entropia/Teebeutel-Hardware/README.md

# Teebeutel

An (experimental) ESP32-dev-board in the shape of the Entropia logo.

Head over to the [wiki](https://gitlab.jadyn.dev/jadyn/Teebeutel/-/wikis/home) for more information.

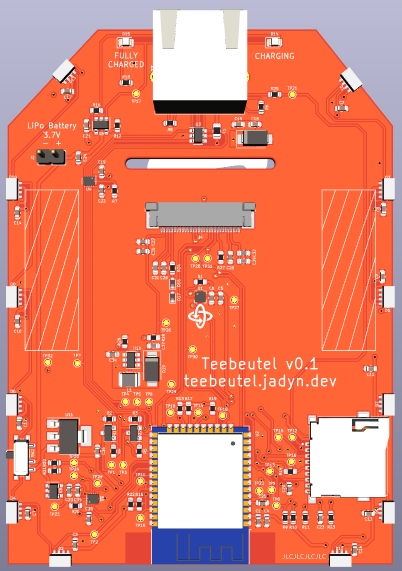
[picture p1: DOCS/3D-Front.png]
3D Render of the front

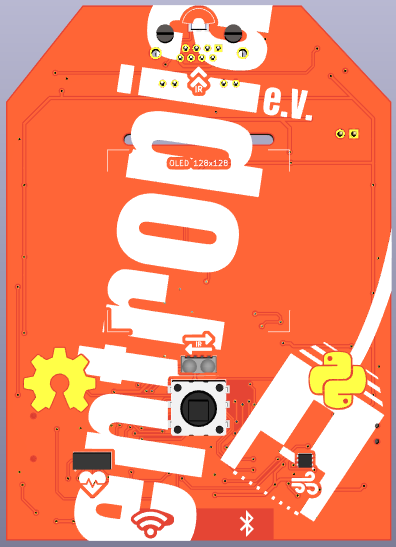
[picture p2: DOCS/3D-Back.png]
3D Render of the back
