entropia/Teebeutel-Hardware/docs/modules/sensor/nav.adoc

* Sensors
** xref:spo2.adoc[]
** xref:gas.adoc[]
** xref:hall-sensor.adoc[]
** xref:touch.adoc[]
** xref:d-pad.adoc[]
