entropia/Teebeutel-Hardware/docs/modules/pcb/nav.adoc

* PCB
** xref:bom.adoc[BOM]
** xref:testpads.adoc[Testpads]
