entropia/Teebeutel-Hardware/graphics/fairydust.png

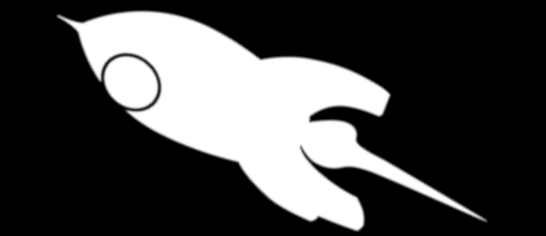
graphics/fairydust.png
