entropia/Teebeutel-Hardware/graphics/name_tag.png

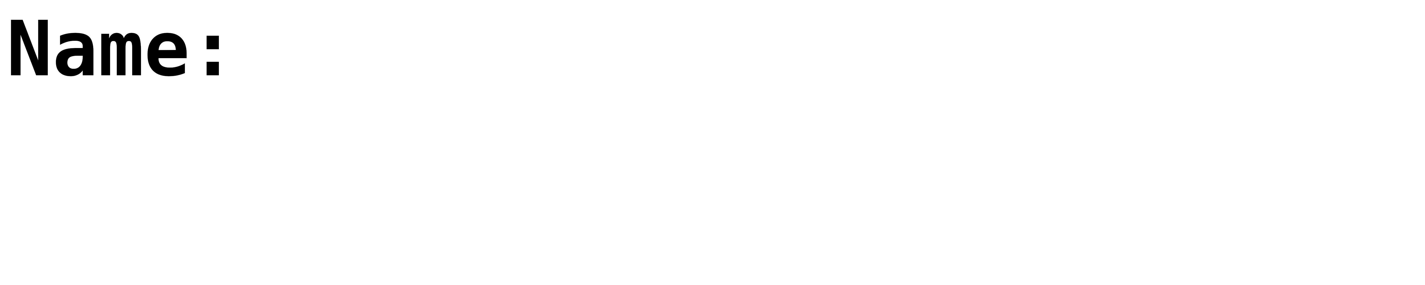
graphics/name_tag.png
