entropia/Teebeutel-Hardware/graphics/teebeutel.png

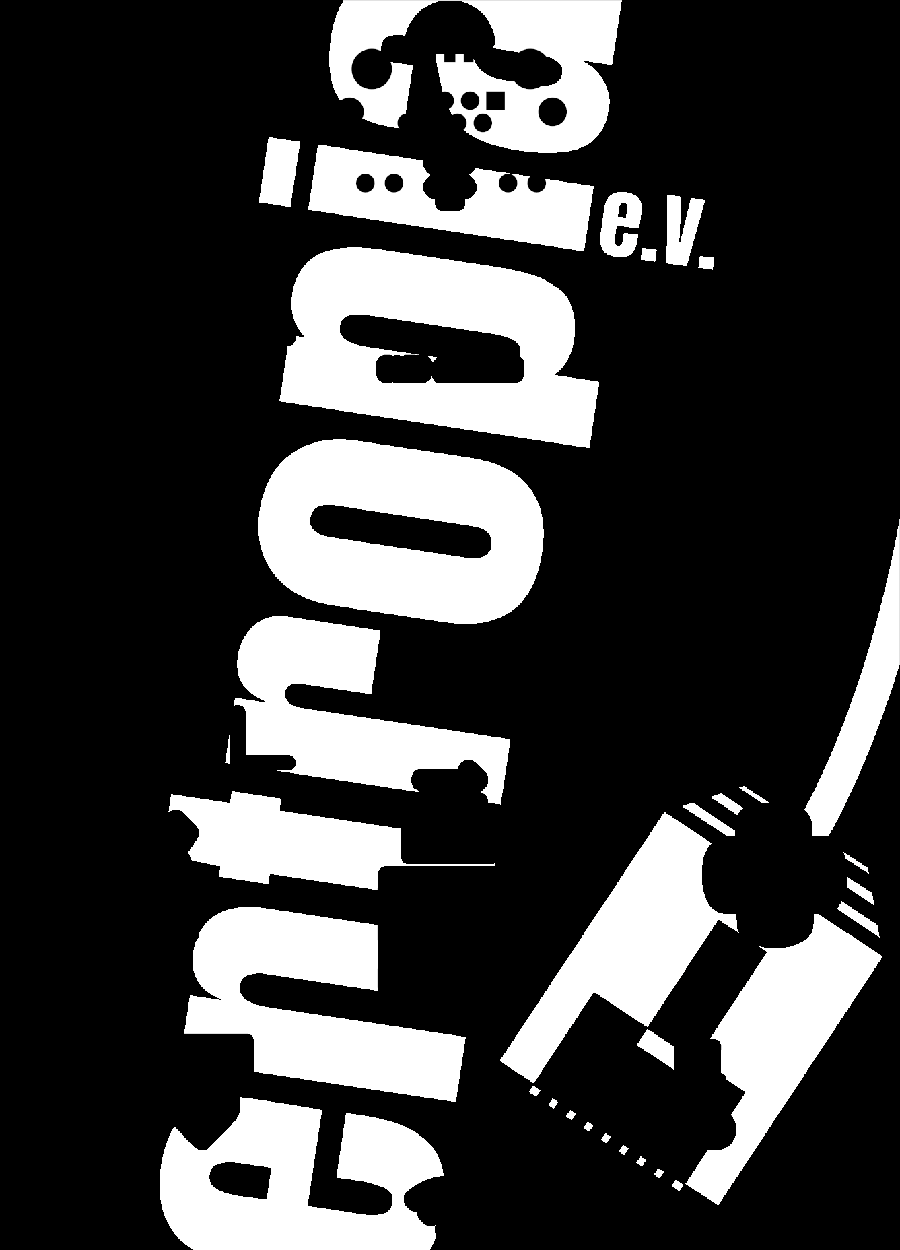
graphics/teebeutel.png
