entropia/Teebeutel-Hardware/docs/modules/pcb/attachments/testpads.csv

Reference | Description
TP1 | ESP32 EN
TP2 | ESP32 IO0
TP3 | DTR 3.3V
TP4 | RTS 3.3V
TP5 | OLED MOSI
TP6 | OLED SCK
TP7 | OLED CS
TP8 | OLED DC
TP9 | OLED RESET
TP10 | OLED VPP (13V)
TP11 | SD-Card SCK
TP12 | SD-Card CS
TP13 | SD-Card MOSI
TP14 | SD-Card MISO
TP15 | I²C SDA 1.8V
TP16 | I²C SCL 1.8V
TP17 | EXP-INT
TP18 | EXP-~RST
TP19 | IR-RX
TP20 | IR-TX
TP21 | WS2821
TP22 | VIBRATION
TP23 | Charging status
TP24 | ADC Battery (1/4 Battery voltage)
TP25 | V +3.3V
TP26 | V +1.8V
