entropia/Teebeutel-Hardware/docs/modules/pcb/pages/testpads.adoc

= Teebeutel Testpads

IMPORTANT: Please make sure that you are viewing the correct version!

== Testpads {page-component-version}

[%header,format=csv]
|===
include::../attachments/testpads.csv[]
|===
