entropia/Teebeutel-Hardware/(threads)

Thread 2 (2021-12-23):

The 3.3v Voltage-Regulator requires 4.7V to work

jadyndev, 2021-12-23:
This IC need 4.7V to work properly. We only have 3.7V when the battery is fully charged!

jadyndev, 2021-12-28:
The voltage regulator was replaced with one that can handle Vout = Vin (TLV62568)

Closed 2021-12-28.

Thread 3 (2021-12-25):

UART lables are swapped

jadyndev, 2021-12-25:
The UART RxD and TxD labels are swapped.

TODO:

- [x] Switch labels without changing the pin assignments on the plug.
- [x] Figure out if the ESP boots with RTS and DTR floating

jadyndev, 2021-12-28:
Booting should work, as the strapping pins are internally pulled up. Not tested tho.

Labels have been swapped and the status LEDs should work as well now

Closed 2021-12-28.

Thread 4 (2022-01-02):

Replace I2C level shifter

Jana-Marie, 2022-01-02:
TXB0104RUT is not suited for I2C, replace with mosfet based level shifter.

Jana-Marie, 2022-01-04:
Fixed with 71fb0764d747d6fe92a1aca003bab7134bcb2dd3

Closed 2022-01-04.

Thread 5 (2022-01-02):

Fix PPSI262 pinout issues

Jana-Marie, 2022-01-02:
- [ ] move SCL from CLK pin 7 to SCL pin 10
- [ ] add 510kOhm pull-down to CLK pin 7
- [ ] figure out what RESETZ needs

Jana-Marie, 2022-01-02:
It might be worth investigating if 620kOhm, already on BOM, works as well.

Jana-Marie, 2022-01-04:
Fixed with 71fb0764d747d6fe92a1aca003bab7134bcb2dd3

Investigating 620kOhm is still to-do

Closed 2022-01-04.

Thread 7 (2022-01-02):

Add polygon cutouts to fine-pitched footprints

Jana-Marie, 2022-01-02:
This should improve the soldering process

Jana-Marie, 2022-01-04:
Fixed with 722751b5af8dbf80599c69b61c2438f96eb9160d

Closed 2022-01-04.

Thread 8 (2022-01-02):

Reduce I2C pullup value?

Jana-Marie, 2022-01-02:
10kOhm is quite alot, it may cause some issues with rise times. It should rather be 3.3kOhm or 5.1KOhm, all 10kOhm can probably changed to 5.1kOhm to keep the BOM count low.

Jana-Marie, 2022-01-04:
fixed with 71fb0764d747d6fe92a1aca003bab7134bcb2dd3

Closed 2022-01-04.

Thread 13 (2022-01-20):

Replace S8050 (Q1, Q2) with AO3400

Jana-Marie, 2022-01-20:
This will reduce BOM count by another entry, this should work, lets test it.

jadyndev, 2022-02-13:
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
Just like this?

Jana-Marie, 2022-02-14:
Yes, but please test it first, not sure how stable it is.
