entropia/Teebeutel-Hardware/Teebeutel.kicad_pcb

## KiCad design Teebeutel.kicad_pcb (2022-03-07)

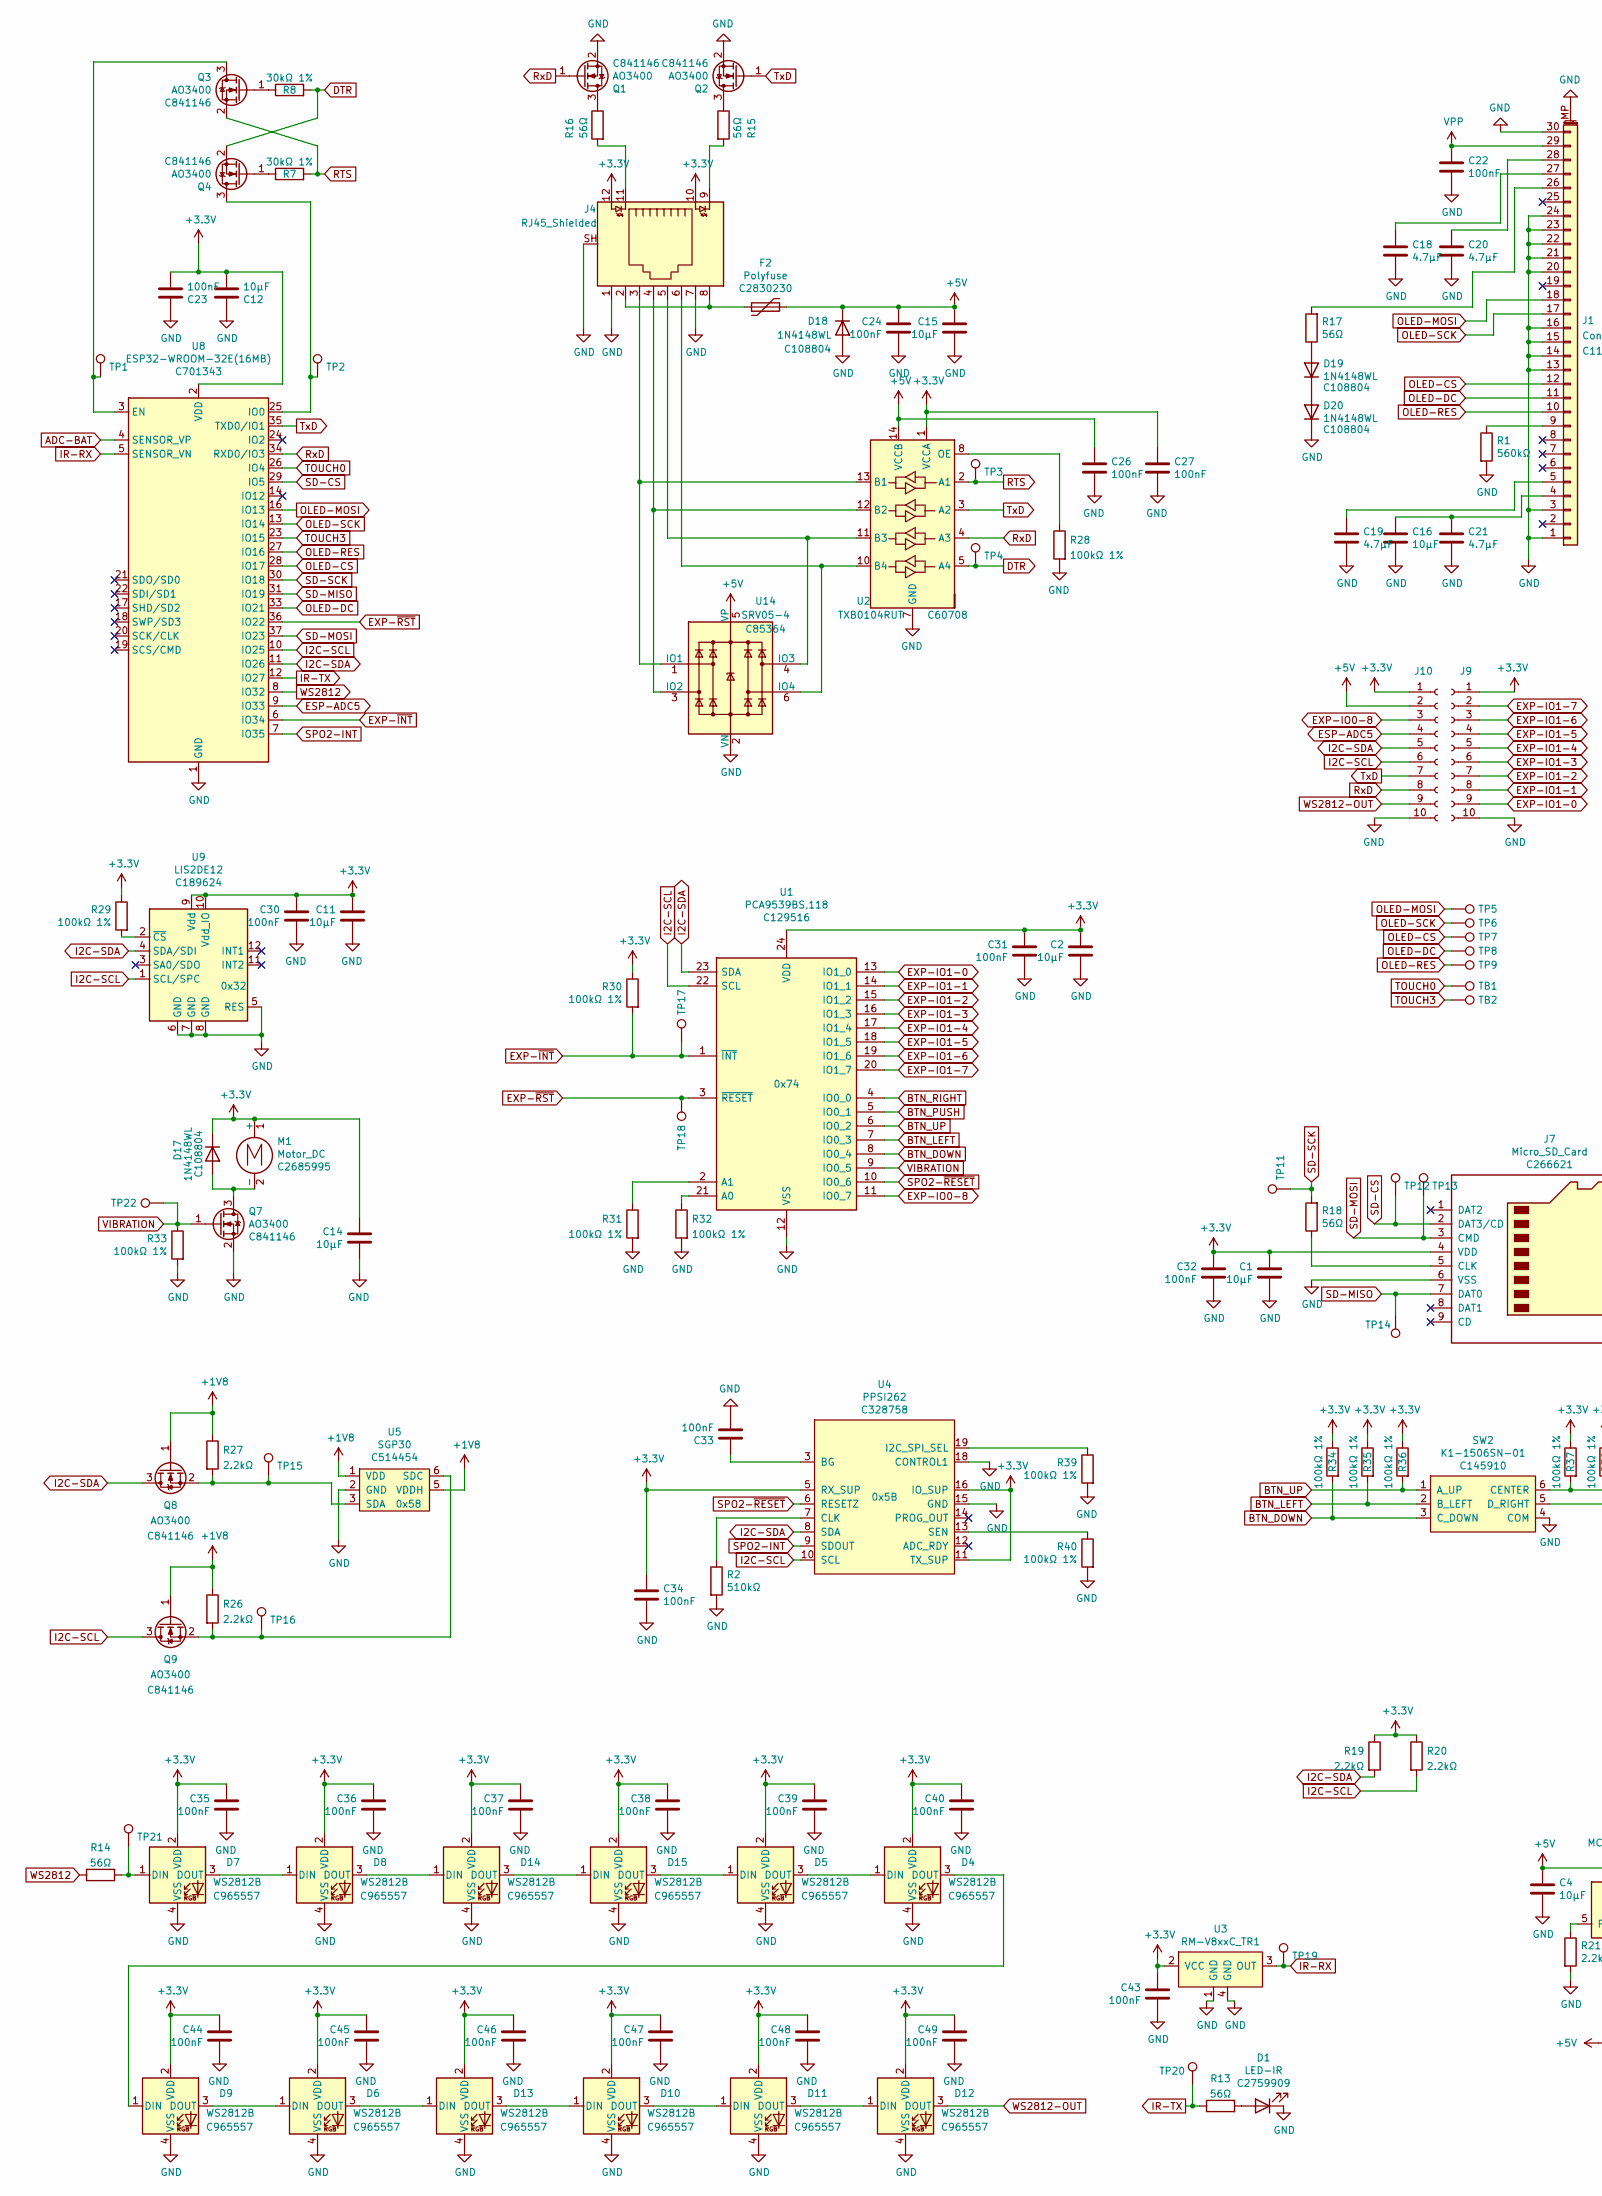
[picture p6: schematic Teebeutel.kicad_sch, part in row 1, column 1]

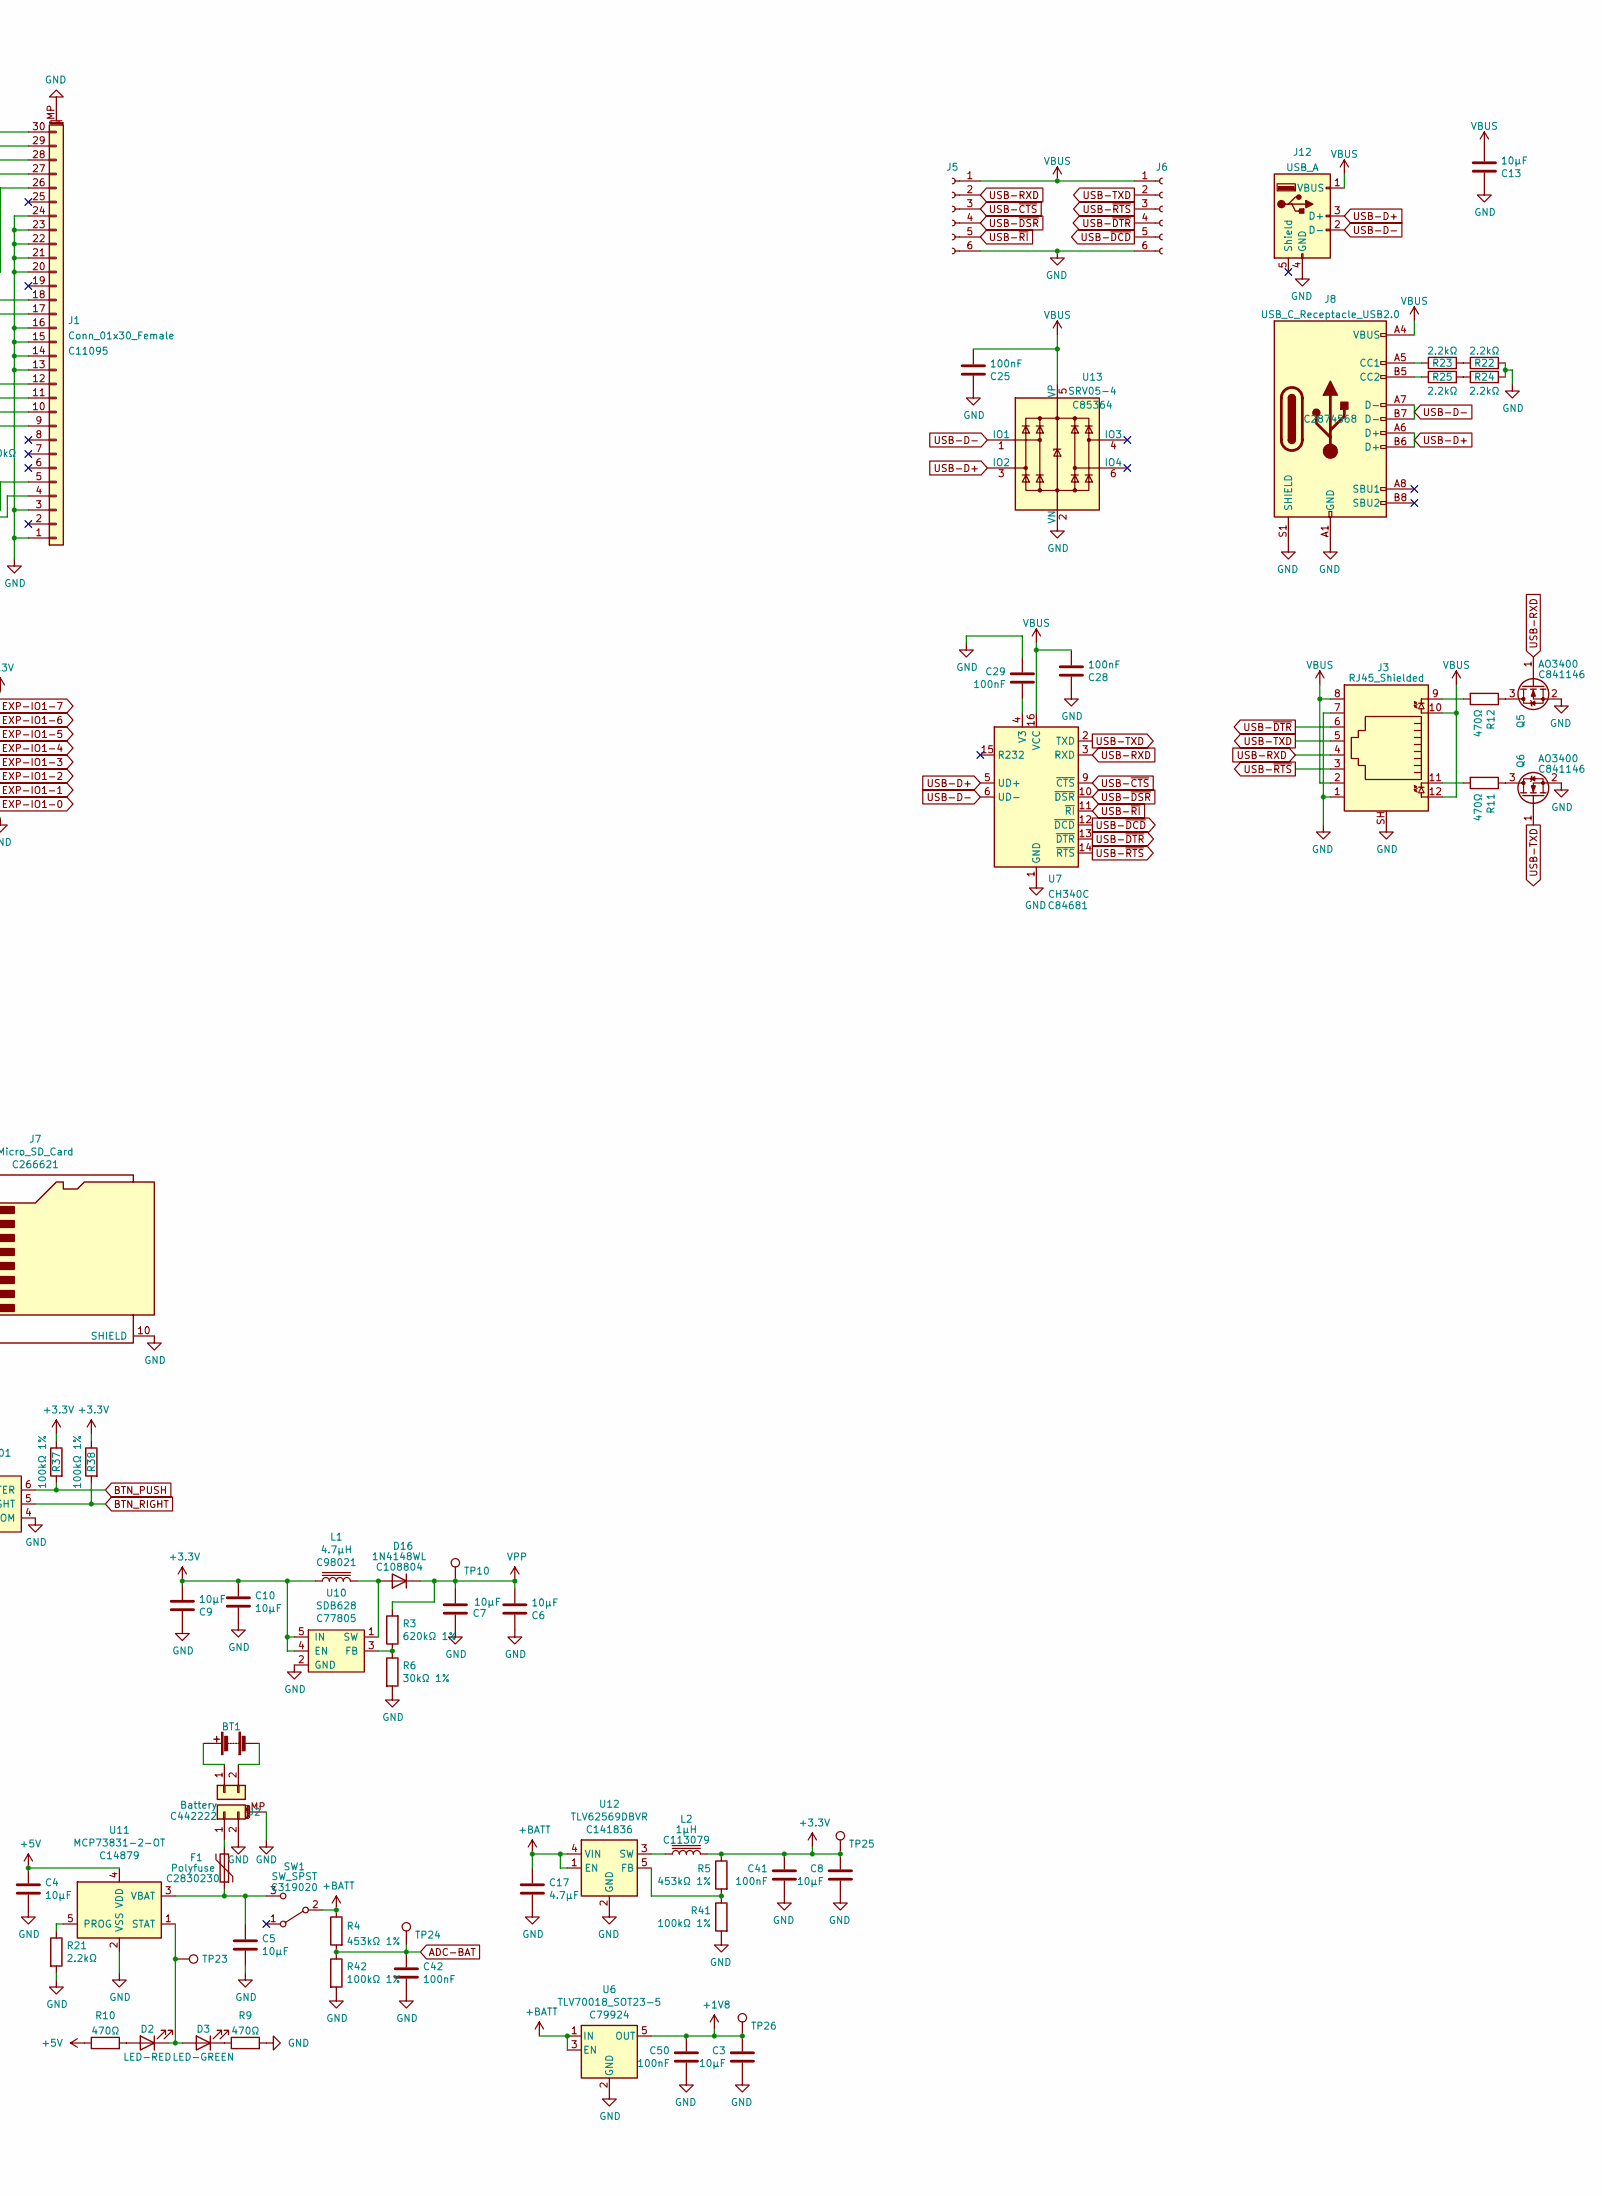
[picture p7: schematic Teebeutel.kicad_sch, part in row 1, column 2]

Parts:
BT1: Battery
C1, C2, C3, C4, C5, C6, C7, C8, C9, C10, C11, C12, C13, C14, C15, C16: 10µF; C_0603_1608Metric; LCSC C19702
C17, C18, C19, C20, C21: 4.7µF; C_0603_1608Metric; LCSC C19666
C22, C23, C24, C25, C26, C27, C28, C29, C30, C31, C32, C33, C34, C35, C36, C37, C38, C39, C40, C41, C42, C43, C44, C45, C46, C47, C48, C49, C50: 100nF; C_0603_1608Metric; LCSC C14663
D1: LED-IR; LKIR30102C; LCSC C2759909
D2: LED-RED; LED_0805_2012Metric; LCSC C84256
D3: LED-GREEN; LED_0805_2012Metric; LCSC C84257
D4, D5, D6, D7, D8, D9, D10, D11, D12, D13, D14, D15: WS2812B; WS2812B-4020; LCSC C965557
D16, D17, D18, D19, D20: 1N4148WL; D_SOD-123F; LCSC C108804
F1, F2: Polyfuse; Fuse_0805_2012Metric; LCSC C2830230
J1: Conn_01x30_Female; TE_3-1734839-0_1x30-1MP_P0.5mm_Horizontal; LCSC C11095
J2: Battery; JST_PH_S2B-PH-SM4-TB_1x02-1MP_P2.00mm_Horizontal; LCSC C442222
J3, J4: RJ45_Shielded; RJ45_Amphenol_RJHSE538X; LCSC C464587
J5: Conn_01x06_Female; PinSocket_1x06_P2.54mm_Vertical_SMD_Pin1Right; MOUSER 801-83-006-30-001101
J6: Conn_01x06_Female; PinSocket_1x06_P2.54mm_Vertical_SMD_Pin1Left; MOUSER 801-83-006-30-001101
J7: Micro_SD_Card; TF15X15; LCSC C266621
J8: USB_C_Receptacle_USB2.0; USB_C_Receptacle_Palconn_UTC16-G; LCSC C2874568
J9: Conn_01x10_Female; PinSocket_1x10_P2.54mm_Vertical_SMD_Pin1Left; MOUSER 437-8018301030001101
J10: Conn_01x10_Female; PinSocket_1x10_P2.54mm_Vertical_SMD_Pin1Right; MOUSER 437-8018301030001101
J11: Battery
J12: USB_A; on-pcb-USB-A-Alignment-Holes
L1: 4.7µH; L_1210_3225Metric; LCSC C98021
L2: 1µH; L_1210_3225Metric; LCSC C113079
M1: Motor_DC; LNLON-S3070P; LCSC C2685995
Q1, Q2, Q3, Q4, Q5, Q6, Q7, Q8, Q9: AO3400; SOT-23; LCSC C841146
R1: 560kΩ; R_0603_1608Metric; LCSC C23203
R2: 510kΩ; R_0603_1608Metric; LCSC C23192
R3: 620kΩ 1%; R_0603_1608Metric; LCSC C23219
R4, R5: 453kΩ 1%; R_0603_1608Metric; LCSC C25818
R6, R7, R8: 30kΩ 1%; R_0603_1608Metric; LCSC C22984
R9, R10, R11, R12: 470Ω; R_0603_1608Metric; LCSC C116694
R13, R14, R15, R16, R17, R18: 56Ω; R_0603_1608Metric; LCSC C25196
R19, R20, R21, R22, R23, R24, R25, R26, R27: 2.2kΩ; R_0603_1608Metric; LCSC C113303
R28, R29, R30, R31, R32, R33, R34, R35, R36, R37, R38, R39, R40, R41, R42: 100kΩ 1%; R_0603_1608Metric; LCSC C25803
SW1: SW_SPST; SW_SPDT_PCM12; LCSC C319020
SW2: K1-1506SN-01; LCSC C145910
TB1: Touch Button 1; Touch-Button_Python
TB2: Touch Button 2; Touch-Button_OSHW
TP1: ESP32 EN; TestPoint_Pad_D1.0mm
TP2: ESP32 IO0; TestPoint_Pad_D1.0mm
TP3: DTR 3.3V; TestPoint_Pad_D1.0mm
TP4: RTS 3.3V; TestPoint_Pad_D1.0mm
TP5: OLED MOSI; TestPoint_Pad_D1.0mm
TP6: OLED SCK; TestPoint_Pad_D1.0mm
TP7: OLED CS; TestPoint_Pad_D1.0mm
TP8: OLED DC; TestPoint_Pad_D1.0mm
TP9: OLED RESET; TestPoint_Pad_D1.0mm
TP10: OLED VPP (13V); TestPoint_Pad_D1.0mm
TP11: SD-Card SCK; TestPoint_Pad_D1.0mm
TP12: SD-Card CS; TestPoint_Pad_D1.0mm
TP13: SD-Card MOSI; TestPoint_Pad_D1.0mm
TP14: SD-Card MISO; TestPoint_Pad_D1.0mm
TP15: I²C SDA 1.8V; TestPoint_Pad_D1.0mm
TP16: I²C SCL 1.8V; TestPoint_Pad_D1.0mm
TP17: EXP-INT; TestPoint_Pad_D1.0mm
TP18: EXP-~RST; TestPoint_Pad_D1.0mm
TP19: IR-RX; TestPoint_Pad_D1.0mm
TP20: IR-TX; TestPoint_Pad_D1.0mm
TP21: WS2821; TestPoint_Pad_D1.0mm
TP22: VIBRATION; TestPoint_Pad_D1.0mm
TP23: Charging status; TestPoint_Pad_D1.0mm
TP24: ADC Battery (1/4 Battery voltage); TestPoint_Pad_D1.0mm
TP25: V +3.3V; TestPoint_Pad_D1.0mm
TP26: V +1.8V; TestPoint_Pad_D1.0mm
U1: PCA9539BS,118; TSSOP-24_4.4x7.8mm_P0.65mm; LCSC C129516
U2: TXB0104RUT; TSSOP-14_4.4x5mm_P0.65mm; LCSC C60708
U3: RM-V8xxC_TR1; IRM-V8xxC-TR1; LCSC C264267
U4: PPSI262; LCSC C328758
U5: SGP30; LCSC C514454
U6: TLV70018_SOT23-5; SOT-23-5; LCSC C79924
U7: CH340C; SOIC-16_3.9x9.9mm_P1.27mm; LCSC C84681
U8: ESP32-WROOM-32E(16MB); ESP32-WROOM-32; LCSC C701343
U9: LIS2DE12; LGA-12_2x2mm_P0.5mm; LCSC C189624
U10: SDB628; SOT-23-6; LCSC C77805
U11: MCP73831-2-OT; SOT-23-5; LCSC C14879
U12: TLV62569DBVR; SOT-23-5; LCSC C141836
U13, U14: SRV05-4; SOT-23-6; LCSC C85364

Connections:
+1V8: C3.1, C50.1, Q8.1 (G), Q9.1 (G), R26.1, R27.1, TP26.1, U5.1 (VDD), U5.5 (VDDH), U6.5 (OUT)
+3V3: C1.1, C2.1, C8.1, C9.2, C10.1, C11.1, C12.2, C14.1, C23.2, C27.1, C30.1, C31.1, C32.1, C34.1, C35.1, C36.1, C37.1, C38.1, C39.1, C40.1, C41.1, C43.1, C44.1, C45.1, C46.1, C47.1, C48.1, C49.1, D4.2 (VDD), D5.2 (VDD), D6.2 (VDD), D7.2 (VDD), D8.2 (VDD), D9.2 (VDD), D10.2 (VDD), D11.2 (VDD), D12.2 (VDD), D13.2 (VDD), D14.2 (VDD), D15.2 (VDD), D17.1 (K), J4.10, J4.12, J7.4 (VDD), J9.1, J10.1, L1.1, L2.2, M1.1 (+), R5.1, R19.1, R20.1, R29.1, R30.1, R34.1, R35.1, R36.1, R37.1, R38.1, TP25.1, U1.24 (VDD), U2.1 (VCCA), U3.2 (VCC), U4.5 (RX_SUP), U4.11 (TX_SUP), U4.16 (IO_SUP), U8.2 (VDD), U9.9 (Vdd), U9.10 (Vdd_IO), U10.4 (EN), U10.5 (IN)
+5V: C4.1, C15.1, C24.1, C26.1, D18.1 (K), F2.2, J10.2, R10.1, U2.14 (VCCB), U11.4 (VDD), U14.5 (VP)
+BATT: C17.1, R4.1, SW1.2 (B), U6.1 (IN), U6.3 (EN), U12.1 (EN), U12.4 (VIN)
ADC-BAT: C42.1, R4.2, R42.1, TP24.1, U8.4 (SENSOR_VP)
BTN_DOWN: R34.2, SW2.3 (C_DOWN), U1.8 (IO0_4)
BTN_LEFT: R35.2, SW2.2 (B_LEFT), U1.7 (IO0_3)
BTN_PUSH: R37.2, SW2.6 (CENTER), U1.5 (IO0_1)
BTN_RIGHT: R38.2, SW2.5 (D_RIGHT), U1.4 (IO0_0)
BTN_UP: R36.2, SW2.1 (A_UP), U1.6 (IO0_2)
DTR: Q4.2 (S), R8.2, TP4.1, U2.5 (A4)
ESP-ADC5: J10.4, U8.9 (IO33)
EXP-IO0-8: J10.3, U1.11 (IO0_7)
EXP-IO1-0: J9.9, U1.13 (IO1_0)
EXP-IO1-1: J9.8, U1.14 (IO1_1)
EXP-IO1-2: J9.7, U1.15 (IO1_2)
EXP-IO1-3: J9.6, U1.16 (IO1_3)
EXP-IO1-4: J9.5, U1.17 (IO1_4)
EXP-IO1-5: J9.4, U1.18 (IO1_5)
EXP-IO1-6: J9.3, U1.19 (IO1_6)
EXP-IO1-7: J9.2, U1.20 (IO1_7)
EXP-~INT: R30.2, TP17.1, U1.1 (~INT), U8.6 (IO34)
EXP-~RST: TP18.1, U1.3 (~RESET), U8.36 (IO22)
GND: C1.2, C2.2, C3.2, C4.2, C5.2, C6.1, C7.2, C8.2, C9.1, C10.2, C11.2, C12.1, C13.1, C14.2, C15.2, C16.2, C17.2, C18.2, C19.2, C20.2, C21.2, C22.2, C23.1, C24.2, C25.1, C26.2, C27.2, C28.1, C29.1, C30.2, C31.2, C32.2, C33.2, C34.2, C35.2, C36.2, C37.2, C38.2, C39.2, C40.2, C41.2, C42.2, C43.2, C44.2, C45.2, C46.2, C47.2, C48.2, C49.2, C50.2, D1.1 (K), D4.4 (VSS), D5.4 (VSS), D6.4 (VSS), D7.4 (VSS), D8.4 (VSS), D9.4 (VSS), D10.4 (VSS), D11.4 (VSS), D12.4 (VSS), D13.4 (VSS), D14.4 (VSS), D15.4 (VSS), D18.2 (A), D20.1 (K), J1.1, J1.3, J1.13, J1.14, J1.15, J1.16, J1.20, J1.21, J1.22, J1.23, J1.24, J1.30, J1.MP (MountPin), J2.2, J2.MP (MountPin), J3.1, J3.7, J3.SH, J4.1, J4.7, J4.SH, J5.6, J6.6, J7.6 (VSS), J7.10 (SHIELD), J8.A1 (GND), J8.A12 (GND), J8.B1 (GND), J8.B12 (GND), J8.S1 (SHIELD), J9.10, J10.10, J12.4 (GND), Q1.2 (S), Q2.2 (S), Q5.2 (S), Q6.2 (S), Q7.2 (S), R1.2, R2.2, R6.2, R9.2, R21.2, R22.2, R24.2, R28.2, R31.2, R32.2, R33.2, R39.2, R40.2, R41.2, R42.2, SW2.4 (COM), U1.12 (VSS), U2.7 (GND), U3.1 (GND), U3.4 (GND), U4.15 (GND), U4.18 (CONTROL1), U5.2 (GND), U6.2 (GND), U7.1 (GND), U8.1 (GND), U8.15 (GND), U8.38 (GND), U8.39 (GND), U9.5 (RES), U9.6 (GND), U9.7 (GND), U9.8 (GND), U10.2 (GND), U11.2 (VSS), U12.2 (GND), U13.2 (VN), U14.2 (VN)
I2C-SCL: J10.6, Q9.3 (D), R20.2, U1.22 (SCL), U4.10 (SCL), U8.10 (IO25), U9.1 (SCL/SPC)
I2C-SDA: J10.5, Q8.3 (D), R19.2, U1.23 (SDA), U4.8 (SDA), U8.11 (IO26), U9.4 (SDA/SDI)
IR-RX: TP19.1, U3.3 (OUT), U8.5 (SENSOR_VN)
IR-TX: R13.1, TP20.1, U8.12 (IO27)
unnamed: BT1.1 (+), J11.1
unnamed: BT1.2 (-), J11.2
unnamed: C5.1, F1.1, SW1.3 (C), U11.3 (VBAT)
unnamed: C16.1, C21.1, J1.4
unnamed: C18.1, J1.27
unnamed: C19.1, J1.5
unnamed: C20.1, J1.28
unnamed: C29.2, U7.4 (V3)
unnamed: C33.1, U4.3 (BG)
unnamed: D1.2 (A), R13.2
unnamed: D2.1 (K), D3.2 (A), TP23.1, U11.1 (STAT)
unnamed: D2.2 (A), R10.2
unnamed: D3.1 (K), R9.1
unnamed: D4.1 (DIN), D5.3 (DOUT)
unnamed: D4.3 (DOUT), D9.1 (DIN)
unnamed: D6.1 (DIN), D9.3 (DOUT)
unnamed: D7.1 (DIN), R14.1, TP21.1
unnamed: D7.3 (DOUT), D8.1 (DIN)
unnamed: D10.1 (DIN), D13.3 (DOUT)
unnamed: D10.3 (DOUT), D11.1 (DIN)
unnamed: D11.3 (DOUT), D12.1 (DIN)
unnamed: D6.3 (DOUT), D13.1 (DIN)
unnamed: D8.3 (DOUT), D14.1 (DIN)
unnamed: D14.3 (DOUT), D15.1 (DIN)
unnamed: D5.1 (DIN), D15.3 (DOUT)
unnamed: D16.2 (A), L1.2, U10.1 (SW)
unnamed: D17.2 (A), M1.2 (-), Q7.3 (D)
unnamed: D19.1 (K), D20.2 (A)
unnamed: D19.2 (A), R17.1
unnamed: F1.2, J2.1
unnamed: F2.1, J4.2, J4.8
unnamed: J1.9, R1.1
unnamed: J1.26, R17.2
unnamed: J3.9, R12.2
unnamed: J3.11, R11.2
unnamed: J4.3, U2.13 (B1), U14.1 (IO1)
unnamed: J4.4, U2.12 (B2), U14.3 (IO2)
unnamed: J4.5, U2.11 (B3), U14.4 (IO3)
unnamed: J4.6, U2.10 (B4), U14.6 (IO4)
unnamed: J4.9, R15.2
unnamed: J4.11, R16.2
unnamed: J7.5 (CLK), R18.1
unnamed: J8.A5 (CC1), R23.1
unnamed: J8.B5 (CC2), R25.1
unnamed: L2.1, U12.3 (SW)
unnamed: Q1.3 (D), R16.1
unnamed: Q2.3 (D), R15.1
unnamed: Q3.1 (G), R8.1
unnamed: Q3.3 (D), TP1.1, U8.3 (EN)
unnamed: Q4.1 (G), R7.1
unnamed: Q4.3 (D), TP2.1, U8.25 (IO0)
unnamed: Q5.3 (D), R12.1
unnamed: Q6.3 (D), R11.1
unnamed: Q8.2 (S), R27.2, TP15.1, U5.3 (SDA)
unnamed: Q9.2 (S), R26.2, TP16.1, U5.6 (SDC)
unnamed: R2.1, U4.7 (CLK)
unnamed: R3.1, R6.1, U10.3 (FB)
unnamed: R21.1, U11.5 (PROG)
unnamed: R22.1, R23.2
unnamed: R24.1, R25.2
unnamed: R28.1, U2.8 (OE)
unnamed: R29.2, U9.2 (~CS)
unnamed: R31.1, U1.2 (A1)
unnamed: R32.1, U1.21 (A0)
unnamed: R39.1, U4.19 (I2C_SPI_SEL)
unnamed: R40.1, U4.13 (SEN)
unnamed: R5.2, R41.1, U12.5 (FB)
OLED-CS: J1.12, TP7.1, U8.28 (IO17)
OLED-DC: J1.11, TP8.1, U8.33 (IO21)
OLED-MOSI: J1.18, TP5.1, U8.16 (IO13)
OLED-RES: J1.10, TP9.1, U8.27 (IO16)
OLED-SCK: J1.17, TP6.1, U8.13 (IO14)
RTS: Q3.2 (S), R7.2, TP3.1, U2.2 (A1)
RxD: J10.8, Q1.1 (G), U2.4 (A3), U8.34 (RXD0/IO3)
SD-CS: J7.2 (DAT3/CD), TP12.1, U8.29 (IO5)
SD-MISO: J7.7 (DAT0), TP14.1, U8.31 (IO19)
SD-MOSI: J7.3 (CMD), TP13.1, U8.37 (IO23)
SD-SCK: R18.2, TP11.1, U8.30 (IO18)
SPO2-INT: U4.9 (SDOUT), U8.7 (IO35)
SPO2-~RESET: U1.10 (IO0_6), U4.6 (RESETZ)
TOUCH0: TB1.1, U8.26 (IO4)
TOUCH3: TB2.1, U8.23 (IO15)
TxD: J10.7, Q2.1 (G), U2.3 (A2), U8.35 (TXD0/IO1)
USB-D+: J8.A6 (D+), J8.B6 (D+), J12.3 (D+), U7.5 (UD+), U13.3 (IO2)
USB-D-: J8.A7 (D-), J8.B7 (D-), J12.2 (D-), U7.6 (UD-), U13.1 (IO1)
USB-RXD: J3.4, J5.2, Q5.1 (G), U7.3 (RXD)
USB-TXD: J3.5, J6.2, Q6.1 (G), U7.2 (TXD)
USB-~CTS: J5.3, U7.9 (~CTS)
USB-~DCD: J6.5, U7.12 (~DCD)
USB-~DSR: J5.4, U7.10 (~DSR)
USB-~DTR: J3.6, J6.4, U7.13 (~DTR)
USB-~RI: J5.5, U7.11 (~RI)
USB-~RTS: J3.3, J6.3, U7.14 (~RTS)
VBUS: C13.2, C25.2, C28.2, J3.2, J3.8, J3.10, J3.12, J5.1, J6.1, J8.A4 (VBUS), J8.A9 (VBUS), J8.B4 (VBUS), J8.B9 (VBUS), J12.1 (VBUS), U7.16 (VCC), U13.5 (VP)
VIBRATION: Q7.1 (G), R33.1, TP22.1, U1.9 (IO0_5)
VPP: C6.2, C7.1, C22.1, D16.1 (K), J1.29, R3.2, TP10.1
WS2812: R14.2, U8.8 (IO32)
WS2812-OUT: D12.3 (DOUT), J10.9

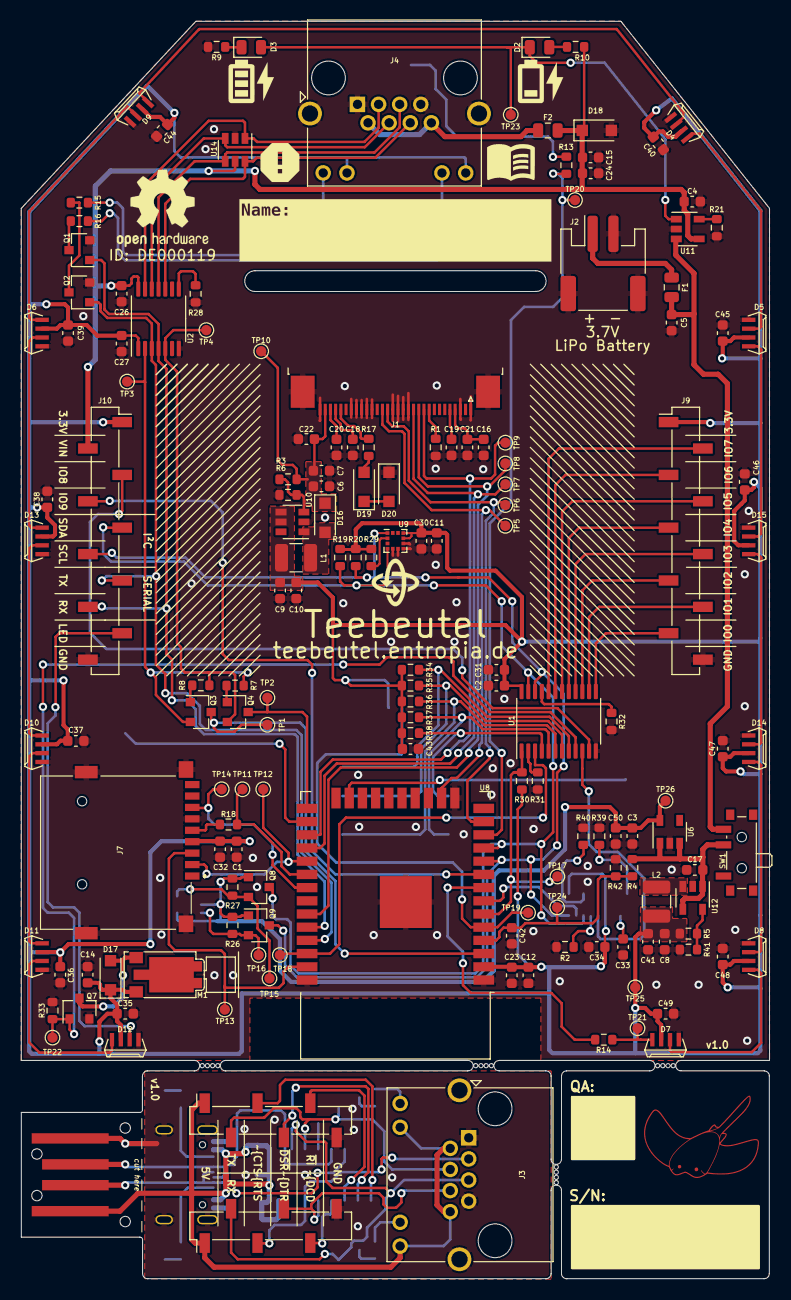
[picture p8: board Teebeutel.kicad_pcb from above]

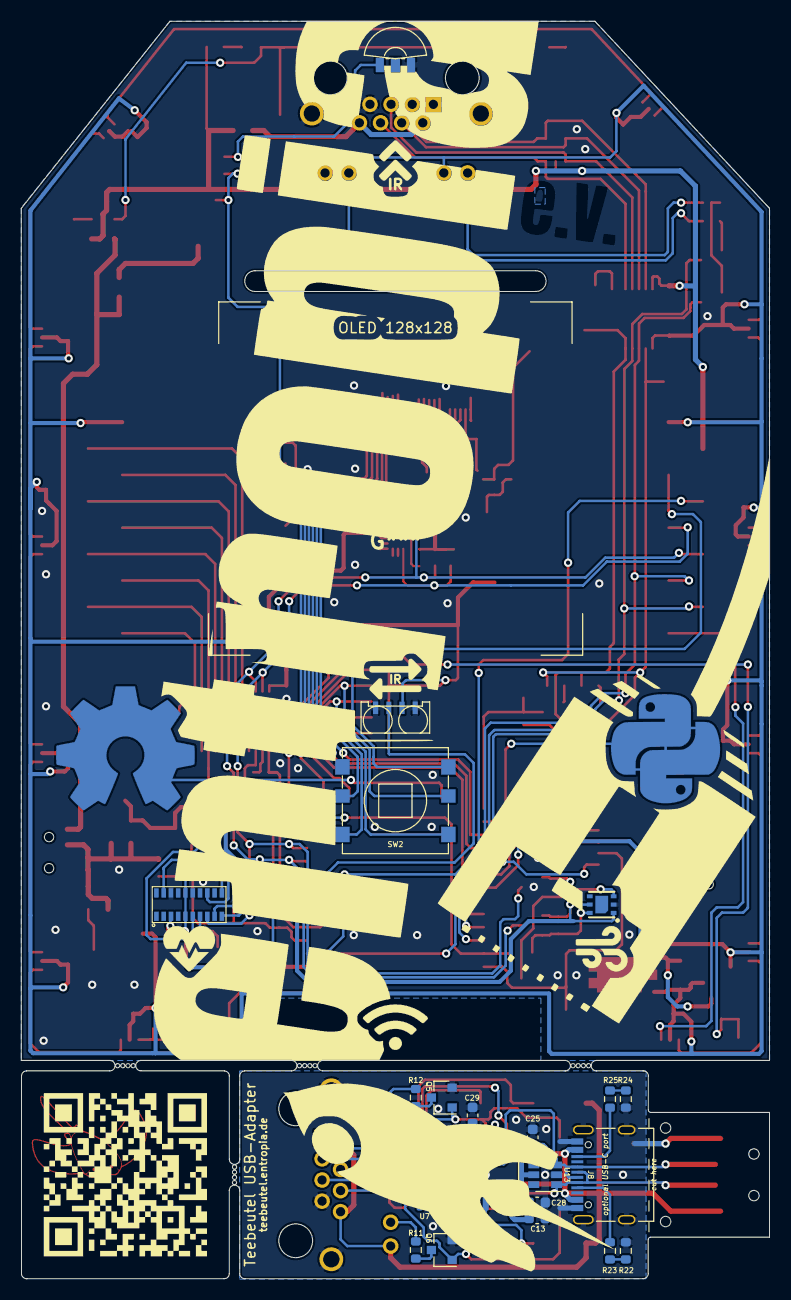
[picture p9: board Teebeutel.kicad_pcb from below]

Board: 2 copper layers, 72.0 x 121.0 mm, 181 parts (22 on the bottom side), 124 nets.
