entropia/Teebeutel-Hardware/(commit log)

2021-11-04 feat: add SD-Card, accelerometer and SDI for display
    [Teebeutel.sch]
2021-11-04 feat: add chargin indicators and touch inputs
    [Teebeutel.sch]
2021-11-04 feat: add ws2812 leds
    [Teebeutel.kicad_pcb, Teebeutel.sch]
2021-11-04 feat: add MORE sensors
    [Teebeutel.sch]
2021-11-04 feat: add SD-Card footprint and some cleanup
    [Teebeutel.kicad_pcb, Teebeutel.sch]
2021-11-04 fix: SD-Card 3D-Model Alignment
    [Teebeutel.kicad_pcb]
2021-11-05 fix: Move pulldown R in the Boot-mode selector
    [Teebeutel.kicad_pcb, Teebeutel.sch]
2021-11-05 feat: add buzzer
    [Teebeutel.sch]
2021-11-05 feat: add llc for uart
    [Teebeutel.sch]
2021-11-06 feat: alot of stuff and routing
    [Teebeutel.sch]
2021-11-06 feat: alot of stuff
    [Teebeutel-B_Cu.gbr, Teebeutel-B_Mask.gbr, Teebeutel-B_Paste.gbr, Teebeutel-B_SilkS.gbr, Teebeutel-Edge_Cuts.gbr, Teebeutel-F_Cu.gbr, Teebeutel-F_Mask.gbr, Teebeutel-F_Paste.gbr]
2021-11-06 feat(): Finished routing and some clean up
    [Teebeutel-B_Cu.gbr, Teebeutel-B_Mask.gbr, Teebeutel-B_Paste.gbr, Teebeutel-B_SilkS.gbr, Teebeutel-Edge_Cuts.gbr, Teebeutel-F_Cu.gbr, Teebeutel-F_Mask.gbr, Teebeutel-F_Paste.gbr]
2021-11-06 feat(): finish routing and assigning JLCPCB part numbers
    [Teebeutel-B_Cu.gbr, Teebeutel-B_Mask.gbr, Teebeutel-B_Paste.gbr, Teebeutel-B_SilkS.gbr, Teebeutel-Edge_Cuts.gbr, Teebeutel-F_Cu.gbr, Teebeutel-F_Mask.gbr, Teebeutel-F_Paste.gbr]
2021-11-07 feat(): add IR-Tranceiver and some 3D-Models
    [Teebeutel.kicad_pcb, Teebeutel.sch]
2021-11-07 feat(): all 3D-Models are in
    [Teebeutel.kicad_pcb]
2021-11-07 fix: rearanged some traces and vias for better GND planes
    [Teebeutel.kicad_pcb]
2021-11-07 feat: Update graphic
    [Teebeutel.kicad_pcb]
2021-11-07 feat: Update gerber files
    [Teebeutel-B_Cu.gbr, Teebeutel-B_Mask.gbr, Teebeutel-B_Paste.gbr, Teebeutel-B_SilkS.gbr, Teebeutel-Edge_Cuts.gbr, Teebeutel-F_Cu.gbr, Teebeutel-F_Mask.gbr, Teebeutel-F_Paste.gbr]
2021-11-07 fix: Improve Vcc Trace
    [Teebeutel.kicad_pcb]
2021-11-08 fix: use the correct display connector
    [Teebeutel.kicad_pcb, Teebeutel.sch]
2021-11-10 feat(): Add graphics
    [Teebeutel-B_Cu.gbr, Teebeutel-B_Mask.gbr, Teebeutel-B_Paste.gbr, Teebeutel-B_SilkS.gbr, Teebeutel-Edge_Cuts.gbr, Teebeutel-F_Cu.gbr, Teebeutel-F_Mask.gbr, Teebeutel-F_Paste.gbr]
2021-11-10 fix(): Small graphics glitches/scaling issues
    [Teebeutel-B_Adhes.gbr, Teebeutel-B_Cu.gbr, Teebeutel-B_Mask.gbr, Teebeutel-B_Paste.gbr, Teebeutel-B_SilkS.gbr, Teebeutel-Edge_Cuts.gbr, Teebeutel-F_Adhes.gbr, Teebeutel-F_Cu.gbr]
2021-11-13 fix+cleanup: more cleanup and fixes, retouched all Cs
    [Teebeutel-B_Adhes.gbr, Teebeutel-B_Cu.gbr, Teebeutel-B_Mask.gbr, Teebeutel-B_Paste.gbr, Teebeutel-B_SilkS.gbr, Teebeutel-F_Adhes.gbr, Teebeutel-F_Cu.gbr, Teebeutel-F_Mask.gbr]
2021-11-15 fix(D16, D17): Change part number
    [Teebeutel.kicad_pcb, Teebeutel.sch, Teebeutel_bom_top.csv]
2021-11-15 feat(): Retouch placement of component labels
    [Teebeutel.kicad_pcb]
2021-11-16 feat(): Add 100nF and 10µF to ESP32-VCC
    [Teebeutel.csv, Teebeutel.kicad_pcb, Teebeutel.sch]
2021-11-16 chore: Cleanup some files
    [Teebeutel.kicad_pcb]
2021-11-16 fix: Change to available LSCS-Parts
    [Teebeutel.sch]
2021-11-16 chore: Update GERBER
    [Teebeutel-B_Adhes.gbr, Teebeutel-B_Cu.gbr, Teebeutel-B_Mask.gbr, Teebeutel-B_Paste.gbr, Teebeutel-B_SilkS.gbr, Teebeutel-F_Adhes.gbr, Teebeutel-F_Cu.gbr, Teebeutel-F_Mask.gbr]
2021-11-17 doc(D11, D19): Add datasheet
    [Teebeutel.sch]
2021-11-18 feat(): add Cs to SD-Card Vcc
    [Teebeutel-B_Adhes.gbr, Teebeutel-B_Cu.gbr, Teebeutel-B_Mask.gbr, Teebeutel-B_Paste.gbr, Teebeutel-B_SilkS.gbr, Teebeutel-F_Adhes.gbr, Teebeutel-F_Cu.gbr, Teebeutel-F_Mask.gbr]
2021-11-18 chore: update refs, bom, documentation
    [Teebeutel-B_Adhes.gbr, Teebeutel-B_Cu.gbr, Teebeutel-B_Mask.gbr, Teebeutel-B_Paste.gbr, Teebeutel-B_SilkS.gbr, Teebeutel-F_Adhes.gbr, Teebeutel-F_Cu.gbr, Teebeutel-F_Mask.gbr]
2021-11-19 feat(): Add name-tag, stencil tooling holes, OSHW-Information
    [Teebeutel-B_Adhes.gbr, Teebeutel-B_Cu.gbr, Teebeutel-B_Mask.gbr, Teebeutel-B_Paste.gbr, Teebeutel-B_SilkS.gbr, Teebeutel-Edge_Cuts.gbr, Teebeutel-F_Adhes.gbr, Teebeutel-F_Cu.gbr]
2021-11-19 chore: generate gerber + drill files
    [Teebeutel-B_Adhes.gbr, Teebeutel-B_Cu.gbr, Teebeutel-B_Mask.gbr, Teebeutel-B_Paste.gbr, Teebeutel-B_SilkS.gbr, Teebeutel-Edge_Cuts.gbr, Teebeutel-F_Adhes.gbr, Teebeutel-F_Cu.gbr]
2021-11-22 fix: Move stencil tooling holes to *.Mask layer
    [Teebeutel.kicad_pcb]
2021-12-01 chore(OSHWA): Add ID (DE000117)
    [Teebeutel.kicad_pcb, Teebeutel.sch]
2021-12-01 feat(ibom): add ibom
    [Teebeutel.kicad_pcb]
2021-12-05 feat(): Started work on v1.0
    [Teebeutel.sch]
2021-12-07 feat: Replace expensive IO-Expantion with cheaper IC
    [Teebeutel.sch]
2021-12-09 Add vibration motor
    [Teebeutel.sch]
2021-12-09 feat: more routing work
    [Teebeutel.kicad_pcb, Teebeutel.sch]
2021-12-12 feat: add I²C Addresses
    [Teebeutel.sch]
2021-12-18 small changes
    [Teebeutel.kicad_pcb, Testpads.ods, bom.csv, bom.ods]
2021-12-20 refactor: clean up old files
    [Teebeutel-B_Cu.gbr, Teebeutel-B_Mask.gbr, Teebeutel-B_Paste.gbr, Teebeutel-B_SilkS.gbr, Teebeutel-Edge_Cuts.gbr, Teebeutel-F_Cu.gbr, Teebeutel-F_Mask.gbr, Teebeutel-F_Paste.gbr]
2021-12-20 docs: Create first documentation and structure
    [bom.csv]
2021-12-28 feat(): Change footprints
    [Teebeutel.kicad_pcb, Teebeutel.sch]
2021-12-29 chore: cleanup and update to KiCad6
    [Teebeutel.kicad_pcb, Teebeutel.kicad_sch, Teebeutel.sch]
2021-12-31 pcb: finish routing
    [Teebeutel.kicad_pcb, Teebeutel.kicad_sch]
2021-12-31 chore: Update version numbers and urls
    [Teebeutel.kicad_pcb, Teebeutel.kicad_sch]
2022-01-03 fix: rework footprint
2022-01-03 Schematic: Lowered I2C pullup to 2.2k, exchanged I2C level shifter, changed FFC to mounting-pin version, fixed PPSI262 pinout
    [Teebeutel.kicad_sch]
2022-01-03 Layout: Routed new PPSI262 layout, added cutout zones for narrow parts, routed new I2C level shifter
    [Teebeutel.kicad_pcb]
2022-01-03 feat(): Connect ~RESET from PPSI to IO-Exp
    [Teebeutel.kicad_pcb, Teebeutel.kicad_sch]
2022-01-03 chore: update docs
    [Teebeutel.kicad_pcb, Teebeutel.kicad_sch, bom.csv, testpads.csv]
2022-01-05 refactor: remove bluetooth icon
    [Teebeutel.kicad_pcb]
2022-01-05 feat(sch): Switch DC-DC converter
    [Teebeutel.kicad_pcb, Teebeutel.kicad_sch, bom.csv]
2022-01-05 feat(esp): Upgrade to latest ESP32-WROOM with 16MB flash
    [Teebeutel.kicad_pcb, Teebeutel.kicad_sch, bom.csv]
2022-01-09 chore(OSHW): Update OSHW-ID
    [Teebeutel.kicad_pcb, Teebeutel.kicad_sch]
2022-01-12 feat(): Add USB-Adaptor
    [Teebeutel.kicad_pcb, Teebeutel.kicad_sch]
2022-01-12 feat(icons): replace text with pictograms
    [Teebeutel.kicad_pcb]
2022-01-12 Schematic: Added capacitors to CH340C
    [Teebeutel.kicad_sch]
2022-01-18 feat(): Add fuse and finalize USB-Adaptor
    [Teebeutel.kicad_pcb, Teebeutel.kicad_sch]
2022-01-20 schematic: removed C24
    [Teebeutel.kicad_sch]
2022-01-20 schematic: removed 10k bom entry, replaced 10k with either 100k or 2.2k; fixed critical I2C level shifter error
    [Teebeutel.kicad_sch]
2022-01-20 schematic: added Pulldown resistors to Type-C receptacle
    [Teebeutel.kicad_sch]
2022-01-20 schematic: added 100nF to RM-V8xxC_TR1
    [Teebeutel.kicad_sch]
2022-01-20 schematic: removed 82ohm BOM entry
    [Teebeutel.kicad_sch]
2022-01-20 schematic: added 10ohm to WS2812 data
    [Teebeutel.kicad_sch]
2022-01-20 schematic: replaced R21, reduced BOM count
    [Teebeutel.kicad_sch]
2022-01-20 schematic: beautify labels
    [Teebeutel.kicad_sch]
2022-01-20 schematic: added ESD protection to USB data lines
    [Teebeutel.kicad_sch]
2022-01-20 schematic: moved J10 and U5 to correct grid
    [Teebeutel.kicad_sch]
2022-01-20 schematic: annotated schematic
    [Teebeutel.kicad_sch]
2022-01-21 rebase(): Delete unused file
    [Teebeutel.csv]
2022-01-21 refactor(): Use bigger sheet and clean up
    [Teebeutel.kicad_sch]
2022-01-21 feat(): Update pcb
    [Teebeutel.kicad_pcb, Teebeutel.kicad_sch]
2022-01-21 chore(): Update / Add partnumbers
    [Teebeutel.kicad_pcb, Teebeutel.kicad_sch]
2022-01-22 feat(): Place footprint references
    [Teebeutel.kicad_pcb]
2022-02-13 feat(): Reassinged refs, cleanup
    [Teebeutel.kicad_pcb, Teebeutel.kicad_sch]
2022-02-14 chore: Further clean up and BOM reduction
    [Teebeutel.kicad_pcb, Teebeutel.kicad_sch]
2022-02-18 chore(): Cleanup
    [Teebeutel.kicad_pcb, Teebeutel.kicad_sch]
2022-02-19 chore(): Cleanup BOM and update docs
    [Teebeutel.kicad_pcb, Teebeutel.kicad_sch, bom.csv, testpads.csv]
2022-02-21 feat(pcb): Lot's of cleanup and rework
    [Teebeutel.kicad_pcb, Teebeutel.kicad_sch, bom.csv, testpads.csv]
2022-02-24 feat(pcb): Add alternative logo, without the 'e.V.'
2022-02-24 feat(pcb): Add 'e.V.' as CU keepout area
    [Teebeutel.kicad_pcb]
2022-03-07 feat(pcb): Add more alternative logos
    [Teebeutel.kicad_pcb]
2022-03-07 chore(sch): Update partnumbers and names
    [Teebeutel.kicad_sch, bom.csv]
