entropia/Teebeutel-Hardware/(notices)

Notices in the files:
Teebeutel.kicad_pcb:
License: CERN-OHL-S
